brainsmoke/hexboard/README.md

Hexdump display
========

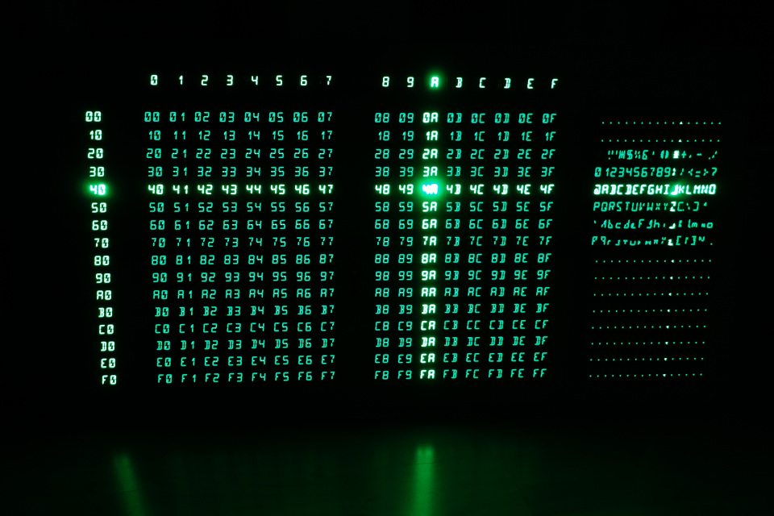
[picture p1: pics/hexboard.jpg]
hd
