brainsmoke/hexboard/firmware/m0matrix/src/README.md

== m0matrix ==

== Template code ==

Based on the template code at:
https://github.com/asquared/stm32f0-barebones-template

which is a stripped-down version of:
https://github.com/szczys/stm32f0-discovery-basic-template
