brainsmoke/hexboard/pcb/horiz/pcb.png

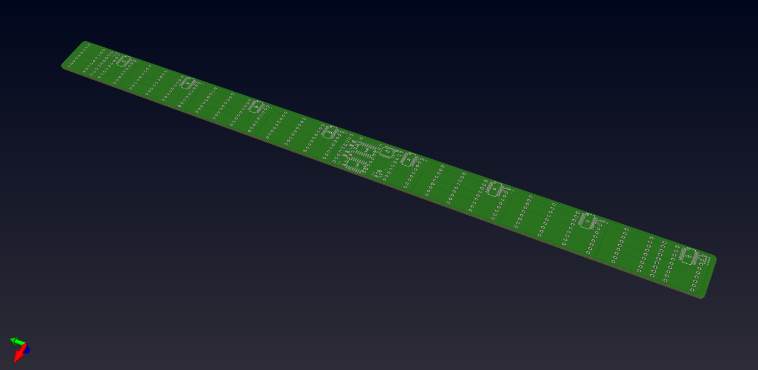
pcb/horiz/pcb.png
