brainsmoke/hexboard/pcb/teensy40_adapter/teensy40_adapter.png

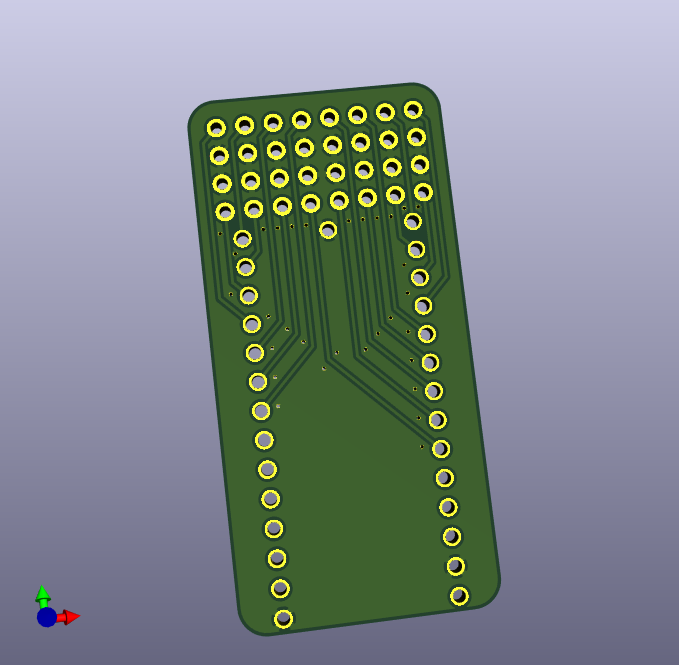
pcb/teensy40_adapter/teensy40_adapter.png
