brainsmoke/hexboard/pcb/teensy40_adapter/teensy40_adapter.kicad_pcb

## KiCad design pcb/teensy40_adapter/teensy40_adapter.kicad_pcb (2022-09-30)

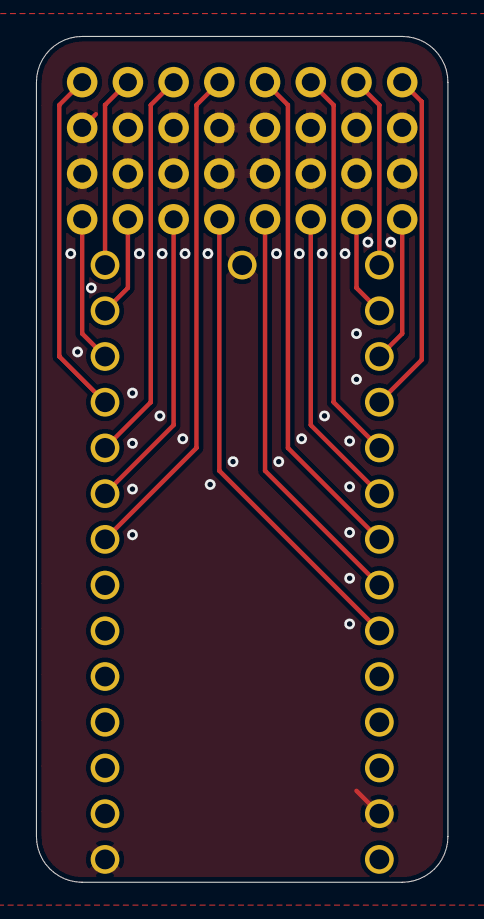
[picture p4: board teensy40_adapter.kicad_pcb from above]

Board: 2 copper layers, 22.9 x 47.0 mm, 3 parts (1 on the bottom side), 17 nets.

Parts:
J1, J2: Conn_02x08_Odd_Even; PinHeader_2x08_P2.54mm_Vertical
U1: Teensy4.0; Teensy40

Connections:
GND: J1.2, J1.4, J1.6, J1.8, J1.10, J1.12, J1.14, J1.16, J2.2, J2.4, J2.6, J2.8, J2.10, J2.12, J2.14, J2.16, U1.1, U1.17, U1.32
P0: J2.1, U1.23
P1: J2.3, U1.20
P2: J2.5, U1.24
P3: J2.7, U1.26
P4: J2.9, U1.8
P5: J2.11, U1.10
P6: J2.13, U1.14
P7: J2.15, U1.11
P8: J1.1, U1.12
P9: J1.3, U1.13
P10: J1.5, U1.9
P11: J1.7, U1.28
P12: J1.9, U1.27
P13: J1.11, U1.25
P14: J1.13, U1.21
P15: J1.15, U1.22
