brainsmoke/hexboard/pcb/backplane_vert/hexdump.kicad_pcb

## KiCad design pcb/backplane_vert/hexdump.kicad_pcb (2022-09-30)

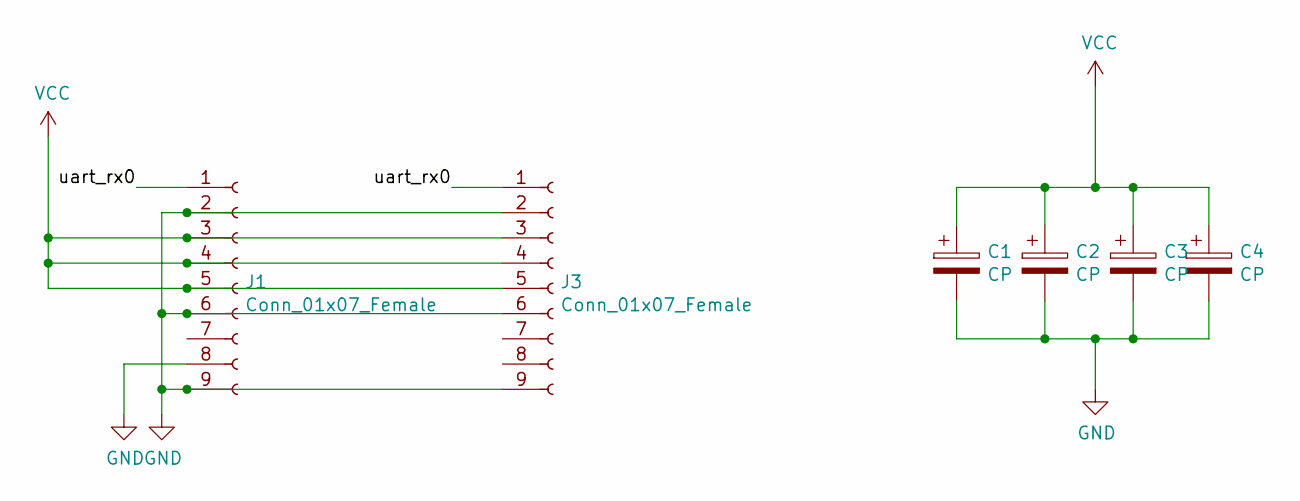
[picture p5: schematic hexdump.sch]

Parts:
C1: CP; CP_Elec_10x10
C2: CP; CP_Elec_8x6.9
C3: CP; C_Radial_D10.0mm_H16.0mm_P5.00mm
C4: CP; C_Radial_D8.0mm_H11.5mm_P3.50mm
J1, J3: Conn_01x07_Female; header-1x9

Connections:
/uart_rx0: J1.1, J3.1
GND: C1.2, C2.2, C3.2, C4.2, J1.2, J1.6, J1.8, J1.9, J3.2, J3.6, J3.9
VCC: C1.1, C2.1, C3.1, C4.1, J1.3, J1.4, J1.5, J3.3, J3.4, J3.5

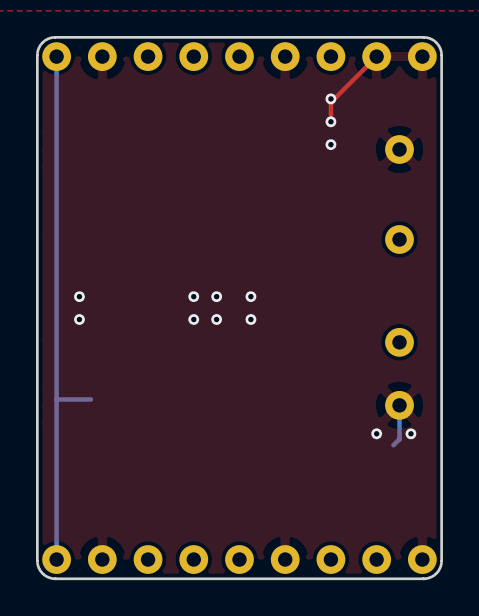
[picture p6: board pcb/backplane_vert/hexdump.kicad_pcb from above]

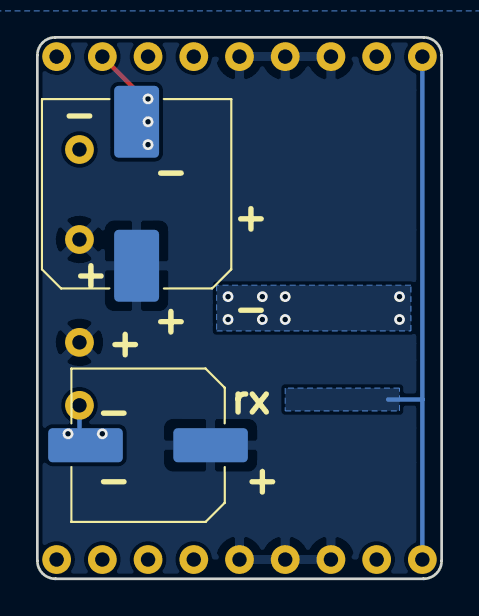
[picture p7: board pcb/backplane_vert/hexdump.kicad_pcb from below]

Board: 2 copper layers, 22.5 x 30.1 mm, 6 parts (3 on the bottom side), 3 nets.
