brainsmoke/hexboard/pcb/horiz/hexdump.kicad_pcb

## KiCad design pcb/horiz/hexdump.kicad_pcb (2019-12-18, an earlier design)

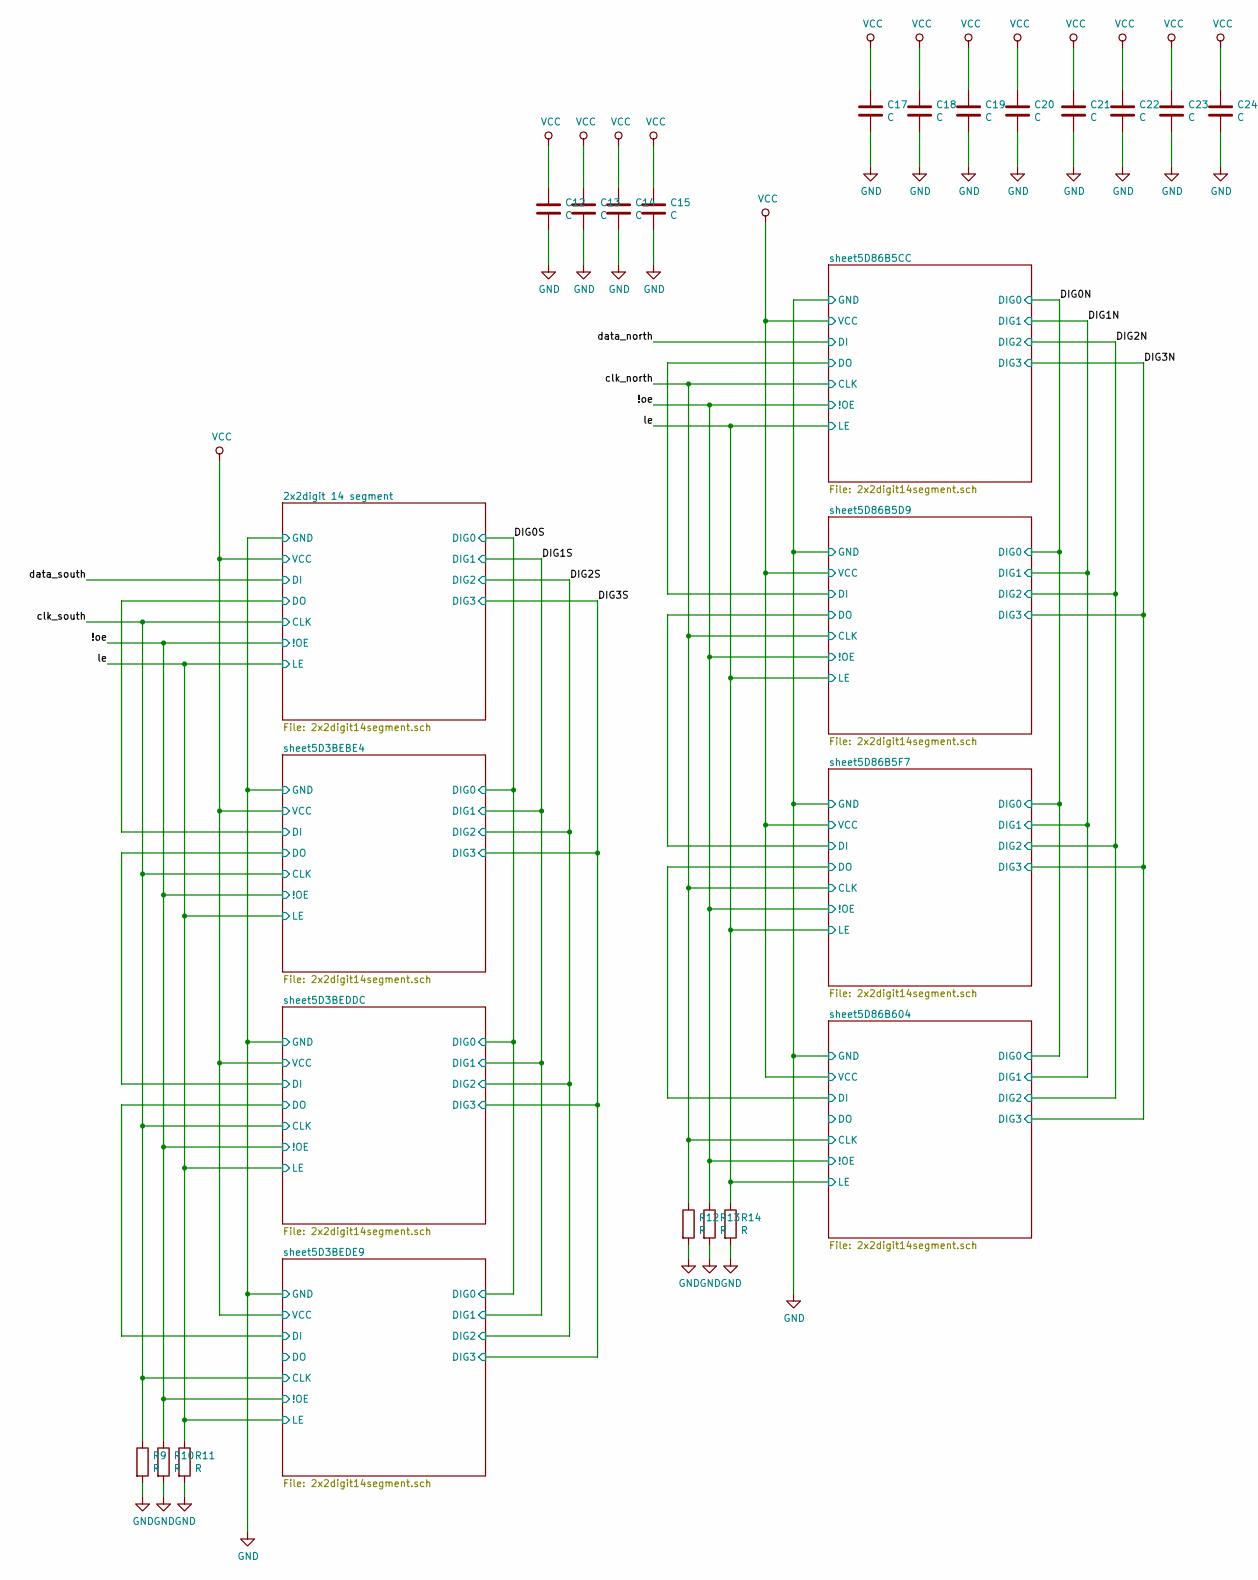
[picture p8: schematic hexdump.sch, part in row 1, column 1]

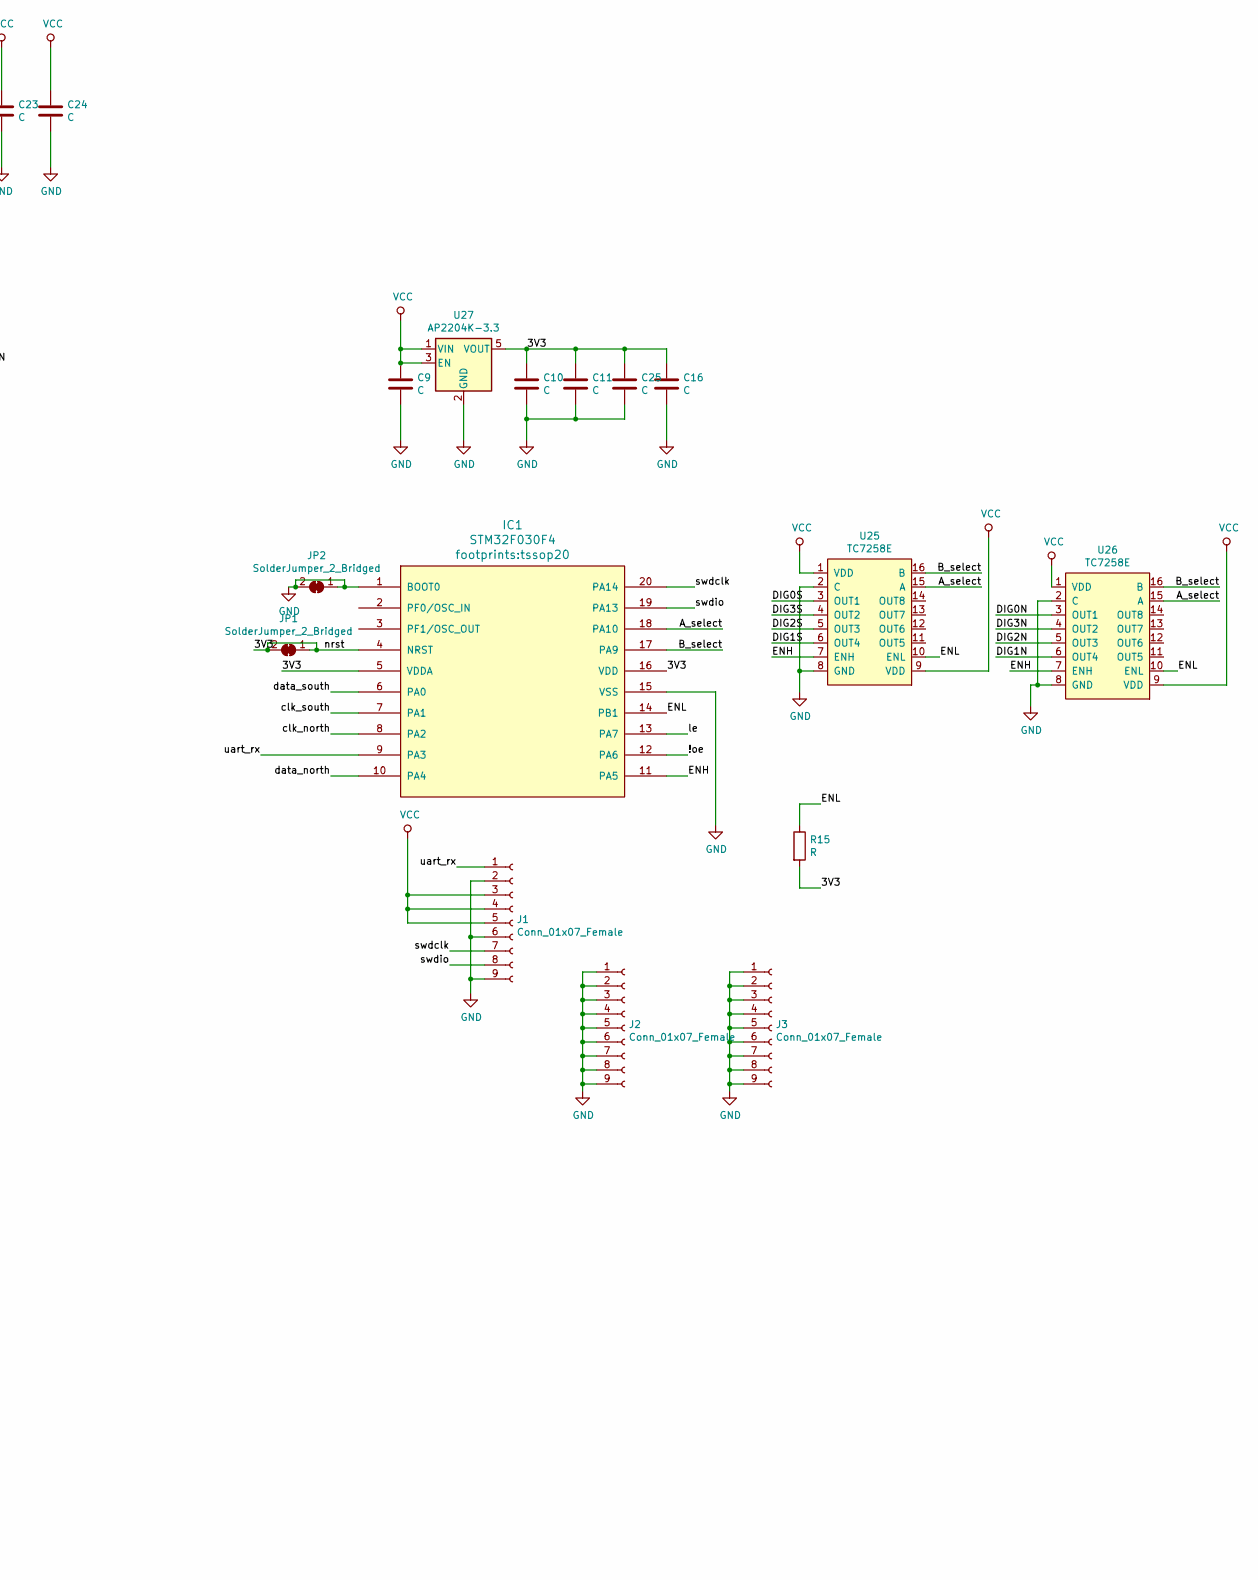
[picture p9: schematic hexdump.sch, part in row 1, column 2]

Parts:
C9, C10, C11, C12, C13, C25: C; C0603
C14, C15, C16, C17, C18, C19, C20, C21, C22, C23, C24: C; C1210
IC1: STM32F030F4; tssop20
J1, J2, J3: Conn_01x07_Female; header-1x7
JP1, JP2: SolderJumper_2_Bridged; SolderJumper-2_P1.3mm_Bridged_RoundedPad1.0x1.5mm
R9, R10, R11, R12, R13, R14, R15: R; R0603
U25, U26: TC7258E; SOP-16-1.27mm
U27: AP2204K-3.3; SOT-23-5

Connections:
/3V3: C10.1, C11.1, C16.1, C25.1, IC1.4 (NRST), IC1.5 (VDDA), IC1.16 (VDD), JP1.1 (A), JP1.2 (B), R15.2, U27.5 (VOUT)
/!oe: IC1.12 (PA6), R10.1, R13.1; also elsewhere on the board
/A_select: IC1.18 (PA10), U25.15 (A), U26.15 (A)
/B_select: IC1.17 (PA9), U25.16 (B), U26.16 (B)
/DIG0N: U26.3 (OUT1); also elsewhere on the board
/DIG0S: U25.3 (OUT1); also elsewhere on the board
/DIG1N: U26.6 (OUT4); also elsewhere on the board
/DIG1S: U25.6 (OUT4); also elsewhere on the board
/DIG2N: U26.5 (OUT3); also elsewhere on the board
/DIG2S: U25.5 (OUT3); also elsewhere on the board
/DIG3N: U26.4 (OUT2); also elsewhere on the board
/DIG3S: U25.4 (OUT2); also elsewhere on the board
/ENH: IC1.11 (PA5), U25.7 (ENH), U26.7 (ENH)
/ENL: IC1.14 (PB1), R15.1, U25.10 (ENL), U26.10 (ENL)
/clk_north: IC1.8 (PA2), R12.1; also elsewhere on the board
/clk_south: IC1.7 (PA1), R9.1; also elsewhere on the board
/data_north: IC1.10 (PA4); also elsewhere on the board
/data_south: IC1.6 (PA0); also elsewhere on the board
/le: IC1.13 (PA7), R11.1, R14.1; also elsewhere on the board
/swdclk: IC1.20 (PA14), J1.7
/swdio: IC1.19 (PA13), J1.8
/uart_rx: IC1.9 (PA3), J1.1
GND: C9.2, C10.2, C11.2, C12.2, C13.2, C14.2, C15.2, C16.2, C17.2, C18.2, C19.2, C20.2, C21.2, C22.2, C23.2, C24.2, C25.2, IC1.1 (BOOT0), IC1.15 (VSS), J1.2, J1.6, J1.9, J2.1, J2.2, J2.3, J2.4, J2.5, J2.6, J2.7, J2.8, J2.9, J3.1, J3.2, J3.3, J3.4, J3.5, J3.6, J3.7, J3.8, J3.9, JP2.1 (A), JP2.2 (B), R9.2, R10.2, R11.2, R12.2, R13.2, R14.2, U25.2 (C), U25.8 (GND), U26.2 (C), U26.8 (GND), U27.2 (GND); also elsewhere on the board
VCC: C9.1, C12.1, C13.1, C14.1, C15.1, C17.1, C18.1, C19.1, C20.1, C21.1, C22.1, C23.1, C24.1, J1.3, J1.4, J1.5, U25.1 (VDD), U25.9 (VDD), U26.1 (VDD), U26.9 (VDD), U27.1 (VIN), U27.3 (EN); also elsewhere on the board

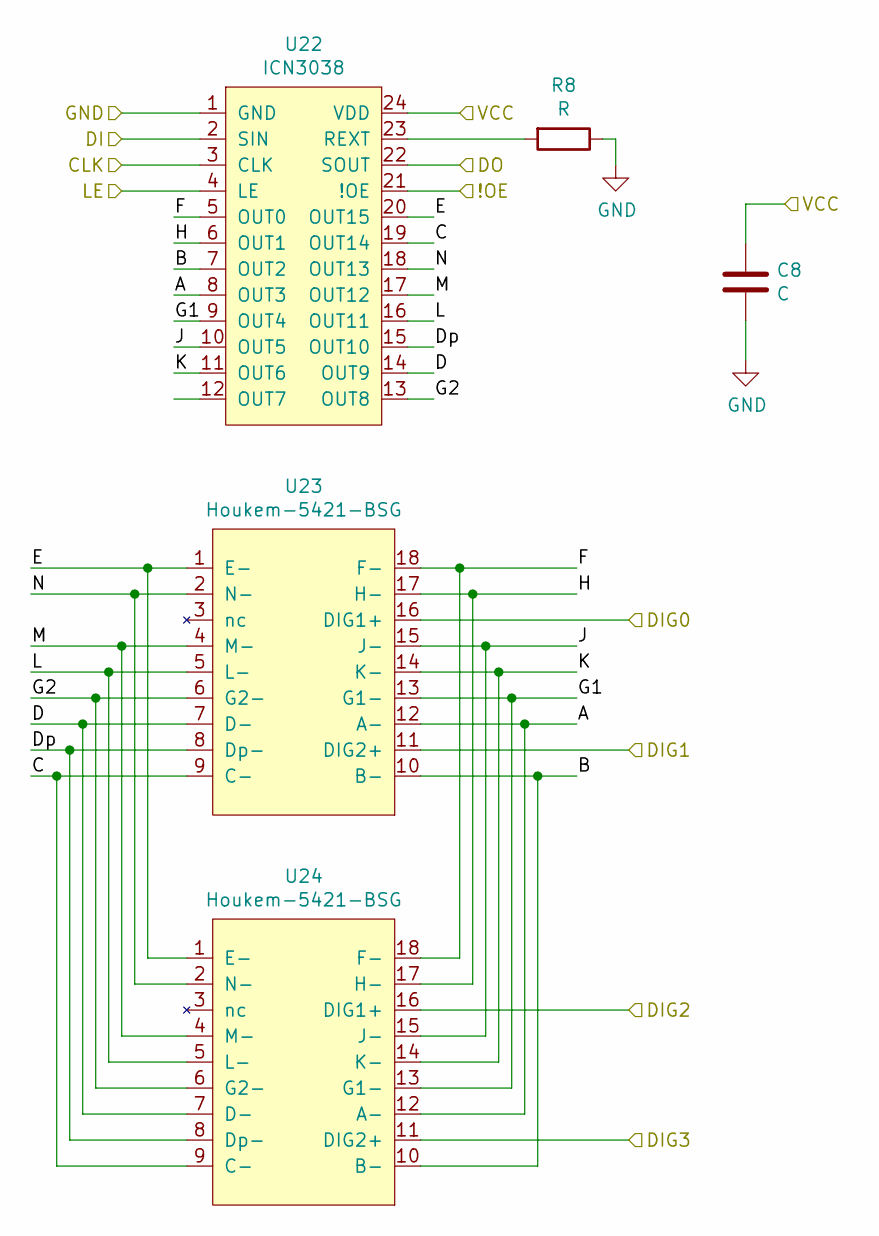
[picture p10: schematic 2x2digit14segment.sch]

Parts:
C1: C; C0603
R1: R; R0603
U1: ICN3038; SSOP-24_3.9x8.7mm_P0.635mm
U2, U3: Houkem-5421-BSG; 2-digit 14 segment display 25.2x21 mm

Connections:
/2x2digit 14 segment/A: U1.8 (OUT3), U2.12 (A-), U3.12 (A-)
/2x2digit 14 segment/B: U1.7 (OUT2), U2.10 (B-), U3.10 (B-)
/2x2digit 14 segment/C: U1.19 (OUT14), U2.9 (C-), U3.9 (C-)
/2x2digit 14 segment/D: U1.14 (OUT9), U2.7 (D-), U3.7 (D-)
/2x2digit 14 segment/Dp: U1.15 (OUT10), U2.8 (Dp-), U3.8 (Dp-)
/2x2digit 14 segment/E: U1.20 (OUT15), U2.1 (E-), U3.1 (E-)
/2x2digit 14 segment/F: U1.5 (OUT0), U2.18 (F-), U3.18 (F-)
/2x2digit 14 segment/G1: U1.9 (OUT4), U2.13 (G1-), U3.13 (G1-)
/2x2digit 14 segment/G2: U1.13 (OUT8), U2.6 (G2-), U3.6 (G2-)
/2x2digit 14 segment/H: U1.6 (OUT1), U2.17 (H-), U3.17 (H-)
/2x2digit 14 segment/J: U1.10 (OUT5), U2.15 (J-), U3.15 (J-)
/2x2digit 14 segment/K: U1.11 (OUT6), U2.14 (K-), U3.14 (K-)
/2x2digit 14 segment/L: U1.16 (OUT11), U2.5 (L-), U3.5 (L-)
/2x2digit 14 segment/M: U1.17 (OUT12), U2.4 (M-), U3.4 (M-)
/2x2digit 14 segment/N: U1.18 (OUT13), U2.2 (N-), U3.2 (N-)
/!oe: U1.21 (!OE); also elsewhere on the board
/DIG0S: U2.16 (DIG1+); also elsewhere on the board
/DIG1S: U2.11 (DIG2+); also elsewhere on the board
/DIG2S: U3.16 (DIG1+); also elsewhere on the board
/DIG3S: U3.11 (DIG2+); also elsewhere on the board
/clk_south: U1.3 (CLK); also elsewhere on the board
/data_south: U1.2 (SIN); also elsewhere on the board
/le: U1.4 (LE); also elsewhere on the board
/sheet5D3BEBE4/DI: U1.22 (SOUT); also elsewhere on the board
GND: C1.2, R1.1, U1.1 (GND); also elsewhere on the board
unnamed: R1.2, U1.23 (REXT)
VCC: C1.1, U1.24 (VDD); also elsewhere on the board

Parts of its further copies:
C2, C3, C4, C5, C6, C7, C8: C; C0603
R2, R3, R4, R5, R6, R7, R8: R; R0603
U4, U7, U10, U13, U16, U19, U22: ICN3038; SSOP-24_3.9x8.7mm_P0.635mm
U5, U6, U8, U9, U11, U12, U14, U15, U17, U18, U20, U21, U23, U24: Houkem-5421-BSG; 2-digit 14 segment display 25.2x21 mm

Connections of its further copies:
/!oe: U4.21 (!OE), U7.21 (!OE), U10.21 (!OE), U13.21 (!OE), U16.21 (!OE), U19.21 (!OE), U22.21 (!OE); also elsewhere on the board
/DIG0N: U14.16 (DIG1+), U17.16 (DIG1+), U20.16 (DIG1+), U23.16 (DIG1+); also elsewhere on the board
/DIG0S: U5.16 (DIG1+), U8.16 (DIG1+), U11.16 (DIG1+); also elsewhere on the board
/DIG1N: U14.11 (DIG2+), U17.11 (DIG2+), U20.11 (DIG2+), U23.11 (DIG2+); also elsewhere on the board
/DIG1S: U5.11 (DIG2+), U8.11 (DIG2+), U11.11 (DIG2+); also elsewhere on the board
/DIG2N: U15.16 (DIG1+), U18.16 (DIG1+), U21.16 (DIG1+), U24.16 (DIG1+); also elsewhere on the board
/DIG2S: U6.16 (DIG1+), U9.16 (DIG1+), U12.16 (DIG1+); also elsewhere on the board
/DIG3N: U15.11 (DIG2+), U18.11 (DIG2+), U21.11 (DIG2+), U24.11 (DIG2+); also elsewhere on the board
/DIG3S: U6.11 (DIG2+), U9.11 (DIG2+), U12.11 (DIG2+); also elsewhere on the board
/clk_north: U13.3 (CLK), U16.3 (CLK), U19.3 (CLK), U22.3 (CLK); also elsewhere on the board
/clk_south: U4.3 (CLK), U7.3 (CLK), U10.3 (CLK); also elsewhere on the board
/data_north: U13.2 (SIN); also elsewhere on the board
/le: U4.4 (LE), U7.4 (LE), U10.4 (LE), U13.4 (LE), U16.4 (LE), U19.4 (LE), U22.4 (LE); also elsewhere on the board
/sheet5D3BEBE4/A: U4.8 (OUT3), U5.12 (A-), U6.12 (A-)
/sheet5D3BEBE4/B: U4.7 (OUT2), U5.10 (B-), U6.10 (B-)
/sheet5D3BEBE4/C: U4.19 (OUT14), U5.9 (C-), U6.9 (C-)
/sheet5D3BEBE4/D: U4.14 (OUT9), U5.7 (D-), U6.7 (D-)
/sheet5D3BEBE4/DI: U4.2 (SIN); also elsewhere on the board
/sheet5D3BEBE4/Dp: U4.15 (OUT10), U5.8 (Dp-), U6.8 (Dp-)
/sheet5D3BEBE4/E: U4.20 (OUT15), U5.1 (E-), U6.1 (E-)
/sheet5D3BEBE4/F: U4.5 (OUT0), U5.18 (F-), U6.18 (F-)
/sheet5D3BEBE4/G1: U4.9 (OUT4), U5.13 (G1-), U6.13 (G1-)
/sheet5D3BEBE4/G2: U4.13 (OUT8), U5.6 (G2-), U6.6 (G2-)
/sheet5D3BEBE4/H: U4.6 (OUT1), U5.17 (H-), U6.17 (H-)
/sheet5D3BEBE4/J: U4.10 (OUT5), U5.15 (J-), U6.15 (J-)
/sheet5D3BEBE4/K: U4.11 (OUT6), U5.14 (K-), U6.14 (K-)
/sheet5D3BEBE4/L: U4.16 (OUT11), U5.5 (L-), U6.5 (L-)
/sheet5D3BEBE4/M: U4.17 (OUT12), U5.4 (M-), U6.4 (M-)
/sheet5D3BEBE4/N: U4.18 (OUT13), U5.2 (N-), U6.2 (N-)
/sheet5D3BEDDC/A: U7.8 (OUT3), U8.12 (A-), U9.12 (A-)
/sheet5D3BEDDC/B: U7.7 (OUT2), U8.10 (B-), U9.10 (B-)
/sheet5D3BEDDC/C: U7.19 (OUT14), U8.9 (C-), U9.9 (C-)
/sheet5D3BEDDC/D: U7.14 (OUT9), U8.7 (D-), U9.7 (D-)
/sheet5D3BEDDC/DI: U4.22 (SOUT), U7.2 (SIN)
/sheet5D3BEDDC/Dp: U7.15 (OUT10), U8.8 (Dp-), U9.8 (Dp-)
/sheet5D3BEDDC/E: U7.20 (OUT15), U8.1 (E-), U9.1 (E-)
/sheet5D3BEDDC/F: U7.5 (OUT0), U8.18 (F-), U9.18 (F-)
/sheet5D3BEDDC/G1: U7.9 (OUT4), U8.13 (G1-), U9.13 (G1-)
/sheet5D3BEDDC/G2: U7.13 (OUT8), U8.6 (G2-), U9.6 (G2-)
/sheet5D3BEDDC/H: U7.6 (OUT1), U8.17 (H-), U9.17 (H-)
/sheet5D3BEDDC/J: U7.10 (OUT5), U8.15 (J-), U9.15 (J-)
/sheet5D3BEDDC/K: U7.11 (OUT6), U8.14 (K-), U9.14 (K-)
/sheet5D3BEDDC/L: U7.16 (OUT11), U8.5 (L-), U9.5 (L-)
/sheet5D3BEDDC/M: U7.17 (OUT12), U8.4 (M-), U9.4 (M-)
/sheet5D3BEDDC/N: U7.18 (OUT13), U8.2 (N-), U9.2 (N-)
/sheet5D3BEDE9/A: U10.8 (OUT3), U11.12 (A-), U12.12 (A-)
/sheet5D3BEDE9/B: U10.7 (OUT2), U11.10 (B-), U12.10 (B-)
/sheet5D3BEDE9/C: U10.19 (OUT14), U11.9 (C-), U12.9 (C-)
/sheet5D3BEDE9/D: U10.14 (OUT9), U11.7 (D-), U12.7 (D-)
/sheet5D3BEDE9/DI: U7.22 (SOUT), U10.2 (SIN)
/sheet5D3BEDE9/DO: U10.22 (SOUT)
/sheet5D3BEDE9/Dp: U10.15 (OUT10), U11.8 (Dp-), U12.8 (Dp-)
/sheet5D3BEDE9/E: U10.20 (OUT15), U11.1 (E-), U12.1 (E-)
/sheet5D3BEDE9/F: U10.5 (OUT0), U11.18 (F-), U12.18 (F-)
/sheet5D3BEDE9/G1: U10.9 (OUT4), U11.13 (G1-), U12.13 (G1-)
/sheet5D3BEDE9/G2: U10.13 (OUT8), U11.6 (G2-), U12.6 (G2-)
/sheet5D3BEDE9/H: U10.6 (OUT1), U11.17 (H-), U12.17 (H-)
/sheet5D3BEDE9/J: U10.10 (OUT5), U11.15 (J-), U12.15 (J-)
/sheet5D3BEDE9/K: U10.11 (OUT6), U11.14 (K-), U12.14 (K-)
/sheet5D3BEDE9/L: U10.16 (OUT11), U11.5 (L-), U12.5 (L-)
/sheet5D3BEDE9/M: U10.17 (OUT12), U11.4 (M-), U12.4 (M-)
/sheet5D3BEDE9/N: U10.18 (OUT13), U11.2 (N-), U12.2 (N-)
/sheet5D86B5CC/A: U13.8 (OUT3), U14.12 (A-), U15.12 (A-)
/sheet5D86B5CC/B: U13.7 (OUT2), U14.10 (B-), U15.10 (B-)
/sheet5D86B5CC/C: U13.19 (OUT14), U14.9 (C-), U15.9 (C-)
/sheet5D86B5CC/D: U13.14 (OUT9), U14.7 (D-), U15.7 (D-)
/sheet5D86B5CC/Dp: U13.15 (OUT10), U14.8 (Dp-), U15.8 (Dp-)
/sheet5D86B5CC/E: U13.20 (OUT15), U14.1 (E-), U15.1 (E-)
/sheet5D86B5CC/F: U13.5 (OUT0), U14.18 (F-), U15.18 (F-)
/sheet5D86B5CC/G1: U13.9 (OUT4), U14.13 (G1-), U15.13 (G1-)
/sheet5D86B5CC/G2: U13.13 (OUT8), U14.6 (G2-), U15.6 (G2-)
/sheet5D86B5CC/H: U13.6 (OUT1), U14.17 (H-), U15.17 (H-)
/sheet5D86B5CC/J: U13.10 (OUT5), U14.15 (J-), U15.15 (J-)
/sheet5D86B5CC/K: U13.11 (OUT6), U14.14 (K-), U15.14 (K-)
/sheet5D86B5CC/L: U13.16 (OUT11), U14.5 (L-), U15.5 (L-)
/sheet5D86B5CC/M: U13.17 (OUT12), U14.4 (M-), U15.4 (M-)
/sheet5D86B5CC/N: U13.18 (OUT13), U14.2 (N-), U15.2 (N-)
/sheet5D86B5D9/A: U16.8 (OUT3), U17.12 (A-), U18.12 (A-)
/sheet5D86B5D9/B: U16.7 (OUT2), U17.10 (B-), U18.10 (B-)
/sheet5D86B5D9/C: U16.19 (OUT14), U17.9 (C-), U18.9 (C-)
/sheet5D86B5D9/D: U16.14 (OUT9), U17.7 (D-), U18.7 (D-)
/sheet5D86B5D9/DI: U13.22 (SOUT), U16.2 (SIN)
/sheet5D86B5D9/Dp: U16.15 (OUT10), U17.8 (Dp-), U18.8 (Dp-)
/sheet5D86B5D9/E: U16.20 (OUT15), U17.1 (E-), U18.1 (E-)
/sheet5D86B5D9/F: U16.5 (OUT0), U17.18 (F-), U18.18 (F-)
/sheet5D86B5D9/G1: U16.9 (OUT4), U17.13 (G1-), U18.13 (G1-)
/sheet5D86B5D9/G2: U16.13 (OUT8), U17.6 (G2-), U18.6 (G2-)
/sheet5D86B5D9/H: U16.6 (OUT1), U17.17 (H-), U18.17 (H-)
/sheet5D86B5D9/J: U16.10 (OUT5), U17.15 (J-), U18.15 (J-)
/sheet5D86B5D9/K: U16.11 (OUT6), U17.14 (K-), U18.14 (K-)
/sheet5D86B5D9/L: U16.16 (OUT11), U17.5 (L-), U18.5 (L-)
/sheet5D86B5D9/M: U16.17 (OUT12), U17.4 (M-), U18.4 (M-)
/sheet5D86B5D9/N: U16.18 (OUT13), U17.2 (N-), U18.2 (N-)
/sheet5D86B5F7/A: U19.8 (OUT3), U20.12 (A-), U21.12 (A-)
/sheet5D86B5F7/B: U19.7 (OUT2), U20.10 (B-), U21.10 (B-)
/sheet5D86B5F7/C: U19.19 (OUT14), U20.9 (C-), U21.9 (C-)
/sheet5D86B5F7/D: U19.14 (OUT9), U20.7 (D-), U21.7 (D-)
/sheet5D86B5F7/DI: U16.22 (SOUT), U19.2 (SIN)
/sheet5D86B5F7/Dp: U19.15 (OUT10), U20.8 (Dp-), U21.8 (Dp-)
/sheet5D86B5F7/E: U19.20 (OUT15), U20.1 (E-), U21.1 (E-)
/sheet5D86B5F7/F: U19.5 (OUT0), U20.18 (F-), U21.18 (F-)
/sheet5D86B5F7/G1: U19.9 (OUT4), U20.13 (G1-), U21.13 (G1-)
/sheet5D86B5F7/G2: U19.13 (OUT8), U20.6 (G2-), U21.6 (G2-)
/sheet5D86B5F7/H: U19.6 (OUT1), U20.17 (H-), U21.17 (H-)
/sheet5D86B5F7/J: U19.10 (OUT5), U20.15 (J-), U21.15 (J-)
/sheet5D86B5F7/K: U19.11 (OUT6), U20.14 (K-), U21.14 (K-)
/sheet5D86B5F7/L: U19.16 (OUT11), U20.5 (L-), U21.5 (L-)
/sheet5D86B5F7/M: U19.17 (OUT12), U20.4 (M-), U21.4 (M-)
/sheet5D86B5F7/N: U19.18 (OUT13), U20.2 (N-), U21.2 (N-)
/sheet5D86B604/A: U22.8 (OUT3), U23.12 (A-), U24.12 (A-)
/sheet5D86B604/B: U22.7 (OUT2), U23.10 (B-), U24.10 (B-)
/sheet5D86B604/C: U22.19 (OUT14), U23.9 (C-), U24.9 (C-)
/sheet5D86B604/D: U22.14 (OUT9), U23.7 (D-), U24.7 (D-)
/sheet5D86B604/DI: U19.22 (SOUT), U22.2 (SIN)
/sheet5D86B604/DO: U22.22 (SOUT)
/sheet5D86B604/Dp: U22.15 (OUT10), U23.8 (Dp-), U24.8 (Dp-)
/sheet5D86B604/E: U22.20 (OUT15), U23.1 (E-), U24.1 (E-)
/sheet5D86B604/F: U22.5 (OUT0), U23.18 (F-), U24.18 (F-)
/sheet5D86B604/G1: U22.9 (OUT4), U23.13 (G1-), U24.13 (G1-)
/sheet5D86B604/G2: U22.13 (OUT8), U23.6 (G2-), U24.6 (G2-)
/sheet5D86B604/H: U22.6 (OUT1), U23.17 (H-), U24.17 (H-)
/sheet5D86B604/J: U22.10 (OUT5), U23.15 (J-), U24.15 (J-)
/sheet5D86B604/K: U22.11 (OUT6), U23.14 (K-), U24.14 (K-)
/sheet5D86B604/L: U22.16 (OUT11), U23.5 (L-), U24.5 (L-)
/sheet5D86B604/M: U22.17 (OUT12), U23.4 (M-), U24.4 (M-)
/sheet5D86B604/N: U22.18 (OUT13), U23.2 (N-), U24.2 (N-)
GND: C2.2, C3.2, C4.2, C5.2, C6.2, C7.2, C8.2, R2.1, R3.1, R4.1, R5.1, R6.1, R7.1, R8.1, U4.1 (GND), U7.1 (GND), U10.1 (GND), U13.1 (GND), U16.1 (GND), U19.1 (GND), U22.1 (GND); also elsewhere on the board
unnamed: R2.2, U4.23 (REXT)
unnamed: R3.2, U7.23 (REXT)
unnamed: R4.2, U10.23 (REXT)
unnamed: R5.2, U13.23 (REXT)
unnamed: R6.2, U16.23 (REXT)
unnamed: R7.2, U19.23 (REXT)
unnamed: R8.2, U22.23 (REXT)
VCC: C2.1, C3.1, C4.1, C5.1, C6.1, C7.1, C8.1, U4.24 (VDD), U7.24 (VDD), U10.24 (VDD), U13.24 (VDD), U16.24 (VDD), U19.24 (VDD), U22.24 (VDD); also elsewhere on the board

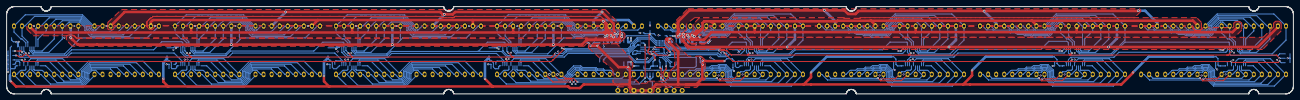
[picture p11: board pcb/horiz/hexdump.kicad_pcb from above]

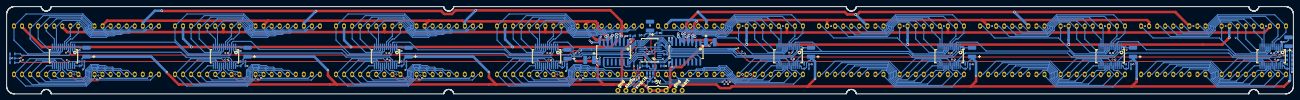
[picture p12: board pcb/horiz/hexdump.kicad_pcb from below]

Board: 4 copper layers, 406.0 x 27.5 mm, 70 parts (53 on the bottom side), 158 nets.
