brainsmoke/hexboard/firmware/teensy3.2/hexdumpserial/hexdumpserial.ino

/*
 * Drive 16 UART LED strip drivers chips at once
 *
 * Protocol:
 *   Frame:         [00-FD]*16384 [FE]
 *   Discard frame: [FF]
 *
 */

#include <HexSerialz.h>
#include <usb_dev.h>

#define N_DATA_BYTES_PER_STRIP 1024
#define N_BYTES_PER_STRIP (N_DATA_BYTES_PER_STRIP + 1)
#define N_DATA_BAUDS_PER_STRIP (10 * N_DATA_BYTES_PER_STRIP)
#define N_BAUDS_PER_STRIP (10 * N_BYTES_PER_STRIP)
#define N_STRIPS 16

#define END_OF_FRAME 0xfe
#define DISCARD_FRAME 0xff

uint16_t buf_a[N_BAUDS_PER_STRIP];
uint16_t buf_b[N_BAUDS_PER_STRIP];
uint16_t *cur, *next;
HexSerialz *hex;

const uint16_t precomp_order[]= /* buffer index & serial line for every 32'th byte */
{
/*
 * buf = []
 * 
 * unused = (0,)
 * top_bar_lines = (8,)
 * 
 * for i in top_bar_lines:
 *     for d in (0, 32):
 *         for j in range(0,32,2):
 *             buf += [ '{:5d}'.format( (j+d)*16*10), '1<<{:2d}'.format(i)]
 * 
 * vertical_lines = ( 12, 14, 15, 13, 11, 9, 6, 4, 2, 0, 1, 3, 5, 7 )
 * 
 * 
 * for i in range(0,32,2):
 *     for j in vertical_lines:
 *         for d in (0, 32):
 *             buf += [ '{:5d}'.format((i+d)*16*10), '1<<{:2d}'.format(j) ]
 * 
 * perline=16
 * 
 * for i in range(len(buf)//perline):
 *     print ( ','.join(buf[i*perline+n] for n in range(perline) )+',' )
 * 
 */

    0,1<< 8,  320,1<< 8,  640,1<< 8,  960,1<< 8, 1280,1<< 8, 1600,1<< 8, 1920,1<< 8, 2240,1<< 8,
 2560,1<< 8, 2880,1<< 8, 3200,1<< 8, 3520,1<< 8, 3840,1<< 8, 4160,1<< 8, 4480,1<< 8, 4800,1<< 8,
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

		while ( !(rx_packet = usb_rx(CDC_RX_ENDPOINT)) || \
		         (rx_packet->index >= rx_packet->len)  );

		rx_i   = rx_packet->index;
		rx_len = rx_packet->len;
	}
	return (uint8_t)rx_packet->buf[rx_i++];
}

static int read_next_frame(void)
{
	int baud_ix=0, c, i, j;
	uint16_t strip_bit;

	for(i=0; i<960; i+=2)
	{
		baud_ix = precomp_order[i];
		strip_bit = precomp_order[i+1];

		for (j=0; j<32; j++)
		{
			c = usb_getchar();
			if (c >= END_OF_FRAME)
				return c == END_OF_FRAME;

			uint16_t *p = &next[baud_ix];

			if (c&0x01) p[1] |=  strip_bit;
			else        p[1] &=~ strip_bit;

			if (c&0x02) p[2] |=  strip_bit;
			else        p[2] &=~ strip_bit;

			if (c&0x04) p[3] |=  strip_bit;
			else        p[3] &=~ strip_bit;

			if (c&0x08) p[4] |=  strip_bit;
			else        p[4] &=~ strip_bit;

			if (c&0x10) p[5] |=  strip_bit;
			else        p[5] &=~ strip_bit;

			if (c&0x20) p[6] |=  strip_bit;
			else        p[6] &=~ strip_bit;

			if (c&0x40) p[7] |=  strip_bit;
			else        p[7] &=~ strip_bit;

			if (c&0x80) p[8] |=  strip_bit;
			else        p[8] &=~ strip_bit;

			baud_ix += 10;
		}
	}

	for (;;)
	{
		c = usb_getchar();
		if (c >= END_OF_FRAME)
			return c == END_OF_FRAME;
	}
}

void setup(void)
{
	usb_init();
}

void loop(void)
{
	memset(buf_a, 0, sizeof(buf_a));
	memset(buf_b, 0, sizeof(buf_b));
	init_buf(buf_a);
	init_buf(buf_b);
	cur = buf_a;
	next = buf_b;
	uint16_t *tmp;

    hex = new HexSerialz(N_BAUDS_PER_STRIP*2, 1000000);
    hex->begin();

    for (;;)
    {
		while(!read_next_frame());
        tmp=cur;
		cur=next;
		next=tmp;
        hex->show(cur);
		memcpy(next, cur, sizeof(buf_a));
    }
}
