brainsmoke/hexboard/(commit log)

2019-09-11 The Hexdump
    [2x2digit14segment.sch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]
2019-12-18 update PCBs
    [2x2digit14segment.sch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]
2019-12-18 add stm32 & teensy firmware
    [stm32f0-openocd.cfg]
2019-12-19 add required teensyduino libs
2022-09-18 16 bit input
    [stm32f0-openocd.cfg]
2022-09-30 clean-up 16 bit stm32 code
2022-09-30 add vertical joiner PCB
    [hexdump.kicad_pcb, hexdump.sch]
2022-09-30 add teensy 4.0 adapter
    [teensy40_adapter.kicad_pcb, teensy40_adapter.sch]
2022-09-30 teensy 4.0 code for parallel synchronous uart tx
2022-10-06 fix pin assignment
2022-10-07 fix fps related code, print fps during routine
2022-10-25 add 8x uart code for teensy 3.2
2022-10-25 fix framebuffer size
2023-10-09 add laser cut case to house a single horizontal bar
